xanderhendriks/pcb-fan-controller/kicad/fan_controller.kicad_pcb

## KiCad design kicad/fan_controller.kicad_pcb (2026-11-07)

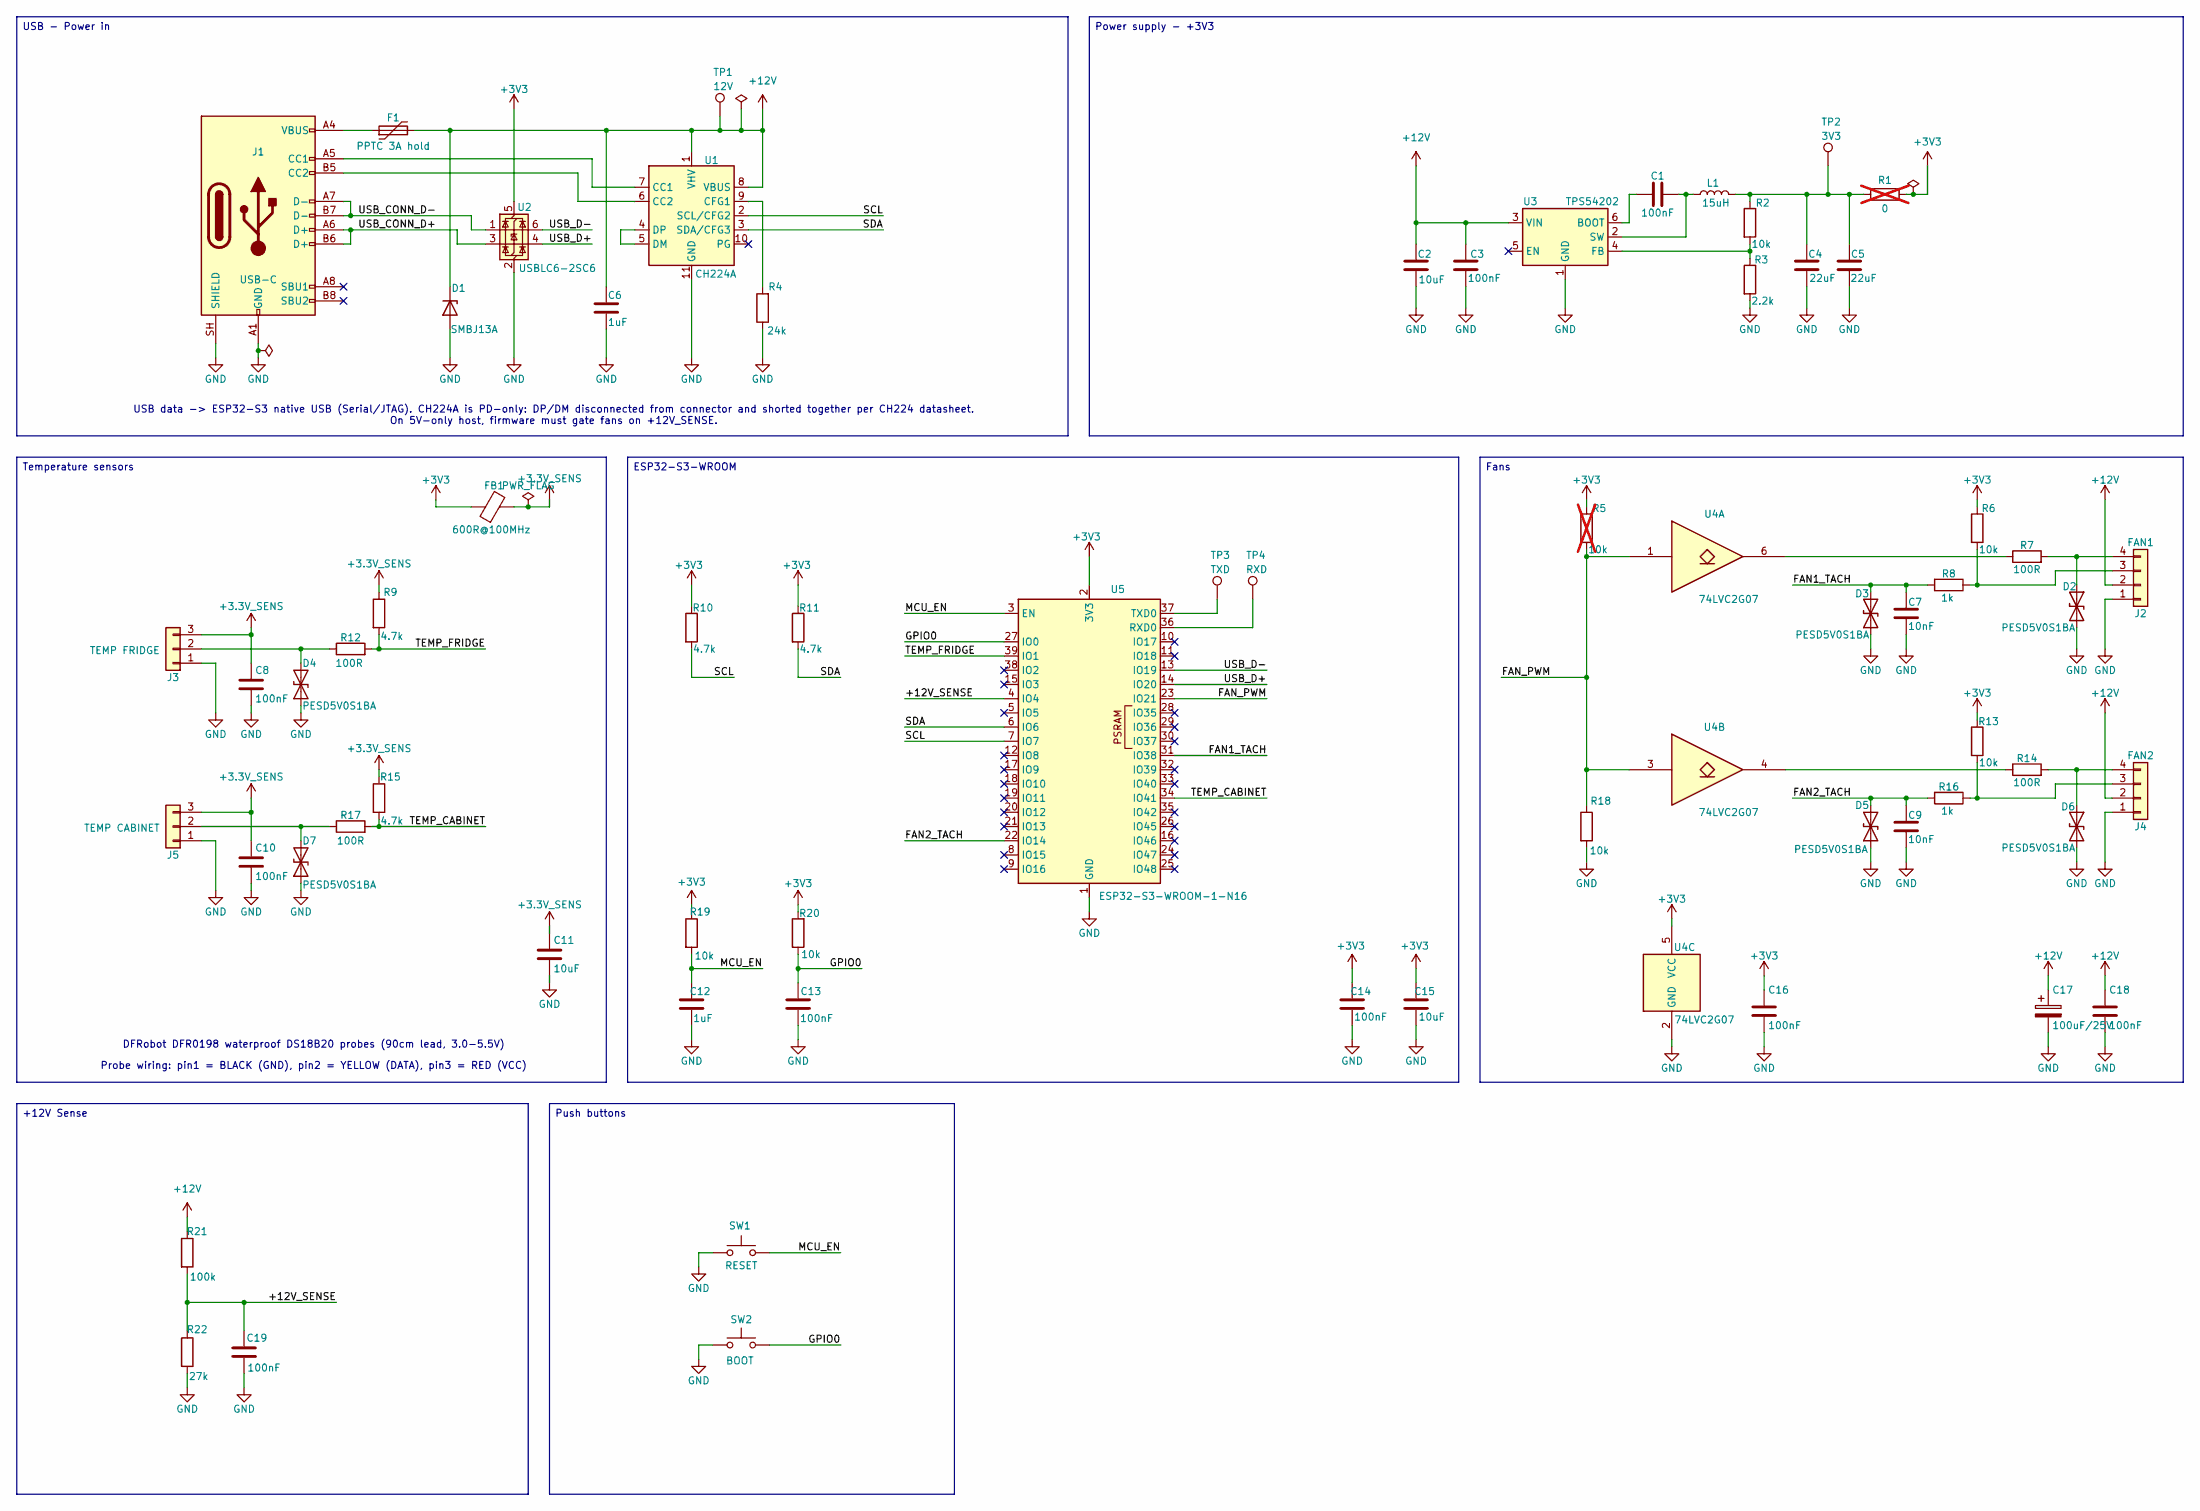
[picture p1: schematic fan_controller.kicad_sch, Fan Controller]

Parts:
C1, C3, C8, C10, C13, C14, C16, C18, C19: 100nF; C_0603_1608Metric; LCSC C14663
C2, C11, C15: 10uF; C_0805_2012Metric; LCSC C15850
C4, C5: 22uF; C_0805_2012Metric; LCSC C45783
C6, C12: 1uF; C_0603_1608Metric; LCSC C15849
C7, C9: 10nF; C_0603_1608Metric; LCSC C57112
C17: 100uF/25V; CP_Elec_6.3x7.7; LCSC C176675
D1: SMBJ13A; D_SMB; LCSC C151252
D2, D3, D4, D5, D6, D7: PESD5V0S1BA; D_SOD-323_HandSoldering; LCSC C19224
F1: PPTC 3A hold; 1812L300_24SLER; LCSC C1512049
FB1: 600R@100MHz; L_0603_1608Metric; LCSC C107335
J1: USB-C; USB_C_Receptacle_GCT_USB4105-xx-A_16P_TopMnt_Horizontal; LCSC C3020560
J2: FAN1; FanPinHeader_1x04_P2.54mm_Vertical; LCSC C240840
J3: TEMP FRIDGE; JST_XH_B3B-XH-A_1x03_P2.50mm_Vertical; LCSC C144394
J4: FAN2; FanPinHeader_1x04_P2.54mm_Vertical; LCSC C240840
J5: TEMP CABINET; JST_XH_B3B-XH-A_1x03_P2.50mm_Vertical; LCSC C144394
L1: 15uH; L_Bourns_SRN5040TA; LCSC C3222254
R1: 0; R_1206_3216Metric; LCSC C17888; not fitted
R2, R6, R13, R18, R19, R20: 10k; R_0603_1608Metric; LCSC C25804
R3: 2.2k; R_0603_1608Metric; LCSC C4190
R4: 24k; R_0603_1608Metric; LCSC C23352
R5: 10k; R_0603_1608Metric; LCSC C25804; not fitted
R7, R12, R14, R17: 100R; R_0603_1608Metric; LCSC C22775
R8, R16: 1k; R_0603_1608Metric; LCSC C21190
R9, R10, R11, R15: 4.7k; R_0603_1608Metric; LCSC C23162
R21: 100k; R_0603_1608Metric; LCSC C25803
R22: 27k; R_0603_1608Metric; LCSC C22967
SW1: RESET; SW_Push_1P1T_NO_CK_KMR2; LCSC C72443
SW2: BOOT; SW_Push_1P1T_NO_CK_KMR2; LCSC C72443
TP1: 12V; TestPoint_Pad_D1.0mm; LCSC N/A
TP2: 3V3; TestPoint_Pad_D1.0mm; LCSC N/A
TP3: TXD; TestPoint_Pad_D1.0mm; LCSC N/A
TP4: RXD; TestPoint_Pad_D1.0mm; LCSC N/A
U1: CH224A; SSOP-10-1EP_3.9x4.9mm_P1mm_EP2.1x3.3mm; LCSC C42459160
U2: USBLC6-2SC6; SOT-23-6; LCSC C7519
U3: TPS54202; SOT-23-6; LCSC C191884
U4: 74LVC2G07; SOT-23-6; LCSC C37708
U5: ESP32-S3-WROOM-1-N16; ESP32-S3-WROOM-1; LCSC C2913199

Connections:
+3.3V_SENS: C8.1, C10.1, C11.1, FB1.2, J3.3, J5.3, R9.1, R15.1
+3V3: C14.1, C15.1, C16.1, FB1.1, R1.2, R5.1, R6.1, R10.1, R11.1, R13.1, R19.1, R20.2, U2.5 (VBUS), U4.5 (VCC), U5.2 (3V3)
+12V: C2.1, C3.2, C6.1, C17.1, C18.1, D1.1 (K), F1.2, J2.2, J4.2, R21.1, TP1.1 (1_1), U1.1 (VHV), U1.8 (VBUS), U3.3 (VIN)
/+12V_SENSE: C19.1, R21.2, R22.1, U5.4 (IO4)
/FAN1_TACH: C7.1, D3.2 (A2), R8.2, U5.31 (IO38)
/FAN2_TACH: C9.1, D5.2 (A2), R16.2, U5.22 (IO14)
/FAN_PWM: R5.2, R18.1, U4.1, U4.3, U5.23 (IO21)
/GPIO0: C13.1, R20.1, SW2.2, U5.27 (IO0)
/MCU_EN: C12.1, R19.2, SW1.2, U5.3 (EN)
/SCL: R10.2, U1.2 (SCL/CFG2), U5.7 (IO7)
/SDA: R11.2, U1.3 (SDA/CFG3), U5.6 (IO6)
/TEMP_CABINET: R15.2, R17.2, U5.34 (IO41)
/TEMP_FRIDGE: R9.2, R12.2, U5.39 (IO1)
/USB_CONN_D+: J1.A6 (D+), J1.B6 (D+), U2.3 (I/O2)
/USB_CONN_D-: J1.A7 (D-), J1.B7 (D-), U2.1 (I/O1)
/USB_D+: U2.4 (I/O2), U5.14 (IO20)
/USB_D-: U2.6 (I/O1), U5.13 (IO19)
GND: C2.2, C3.1, C4.2, C5.2, C6.2, C7.2, C8.2, C9.2, C10.2, C11.2, C12.2, C13.2, C14.2, C15.2, C16.2, C17.2, C18.2, C19.2, D1.2 (A), D2.2 (A2), D3.1 (A1), D4.1 (A1), D5.1 (A1), D6.2 (A2), D7.1 (A1), J1.A1 (GND), J1.A12 (GND), J1.B1 (GND), J1.B12 (GND), J1.SH (SHIELD), J2.1, J3.1, J4.1, J5.1, R3.2, R4.1, R18.2, R22.2, SW1.1, SW2.1, U1.11 (GND), U2.2 (GND), U3.1 (GND), U4.2 (GND), U5.1 (GND), U5.40 (GND), U5.41 (GND)
unnamed: C4.1, C5.1, L1.2, R1.1, R2.1, TP2.1 (1_1)
unnamed: D2.1 (A1), J2.4, R7.2
unnamed: D4.2 (A2), J3.2, R12.1
unnamed: D6.1 (A1), J4.4, R14.2
unnamed: D7.2 (A2), J5.2, R17.1
unnamed: F1.1, J1.A4 (VBUS), J1.A9 (VBUS), J1.B4 (VBUS), J1.B9 (VBUS)
unnamed: J1.A5 (CC1), U1.7 (CC1)
unnamed: J1.B5 (CC2), U1.6 (CC2)
unnamed: J2.3, R6.2, R8.1
unnamed: J4.3, R13.2, R16.1
unnamed: R7.1, U4.6
unnamed: R14.1, U4.4
unnamed: R4.2, U1.9 (CFG1)
unnamed: U1.4 (DP), U1.5 (DM)
unnamed: C1.1, U3.6 (BOOT)
unnamed: R2.2, R3.1, U3.4 (FB)
unnamed: C1.2, L1.1, U3.2 (SW)
unnamed: TP4.1 (1_1), U5.36 (RXD0)
unnamed: TP3.1 (1_1), U5.37 (TXD0)

Notes on the sheet:
Probe wiring: pin1 = BLACK (GND), pin2 = YELLOW (DATA), pin3 = RED (VCC)
USB data -> ESP32-S3 native USB (Serial/JTAG). CH224A is PD-only: DP/DM disconnected from connector and shorted together per CH224 datasheet. On 5V-only host, firmware must gate fans on +12V_SENSE.
DFRobot DFR0198 waterproof DS18B20 probes (90cm lead, 3.0-5.5V)
Push buttons
Power supply - +3V3
ESP32-S3-WROOM
+12V Sense
Temperature sensors
Fans
USB - Power in

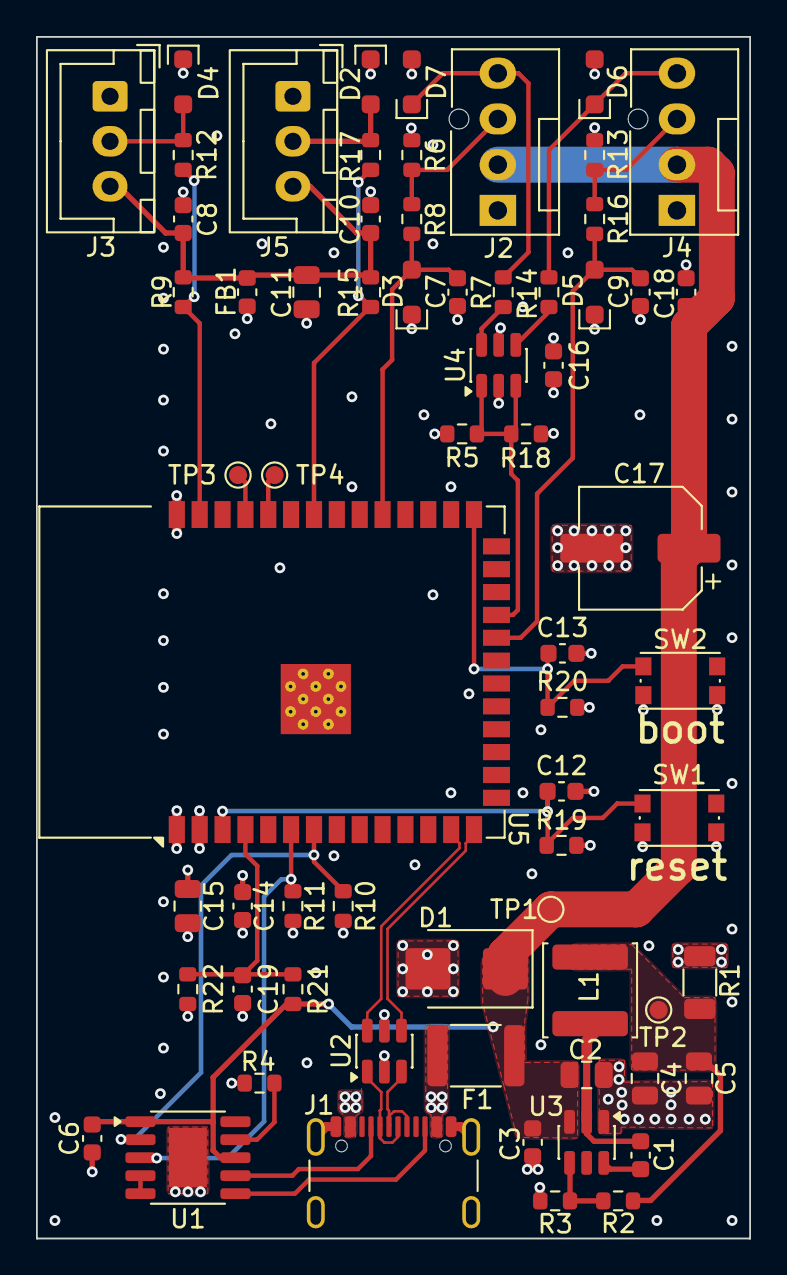
[picture p2: board fan_controller.kicad_pcb from above]

Board: 4 copper layers, 39.6 x 66.8 mm, 67 parts (0 on the bottom side), 37 nets.
