xanderhendriks/pcb-fan-controller/(commit log)

2026-09-12 Completed the schematic.
2026-11-07 Completed the PCB.
